mondaladi/AutoCutOffSystemforSolderingIron/Connections.png

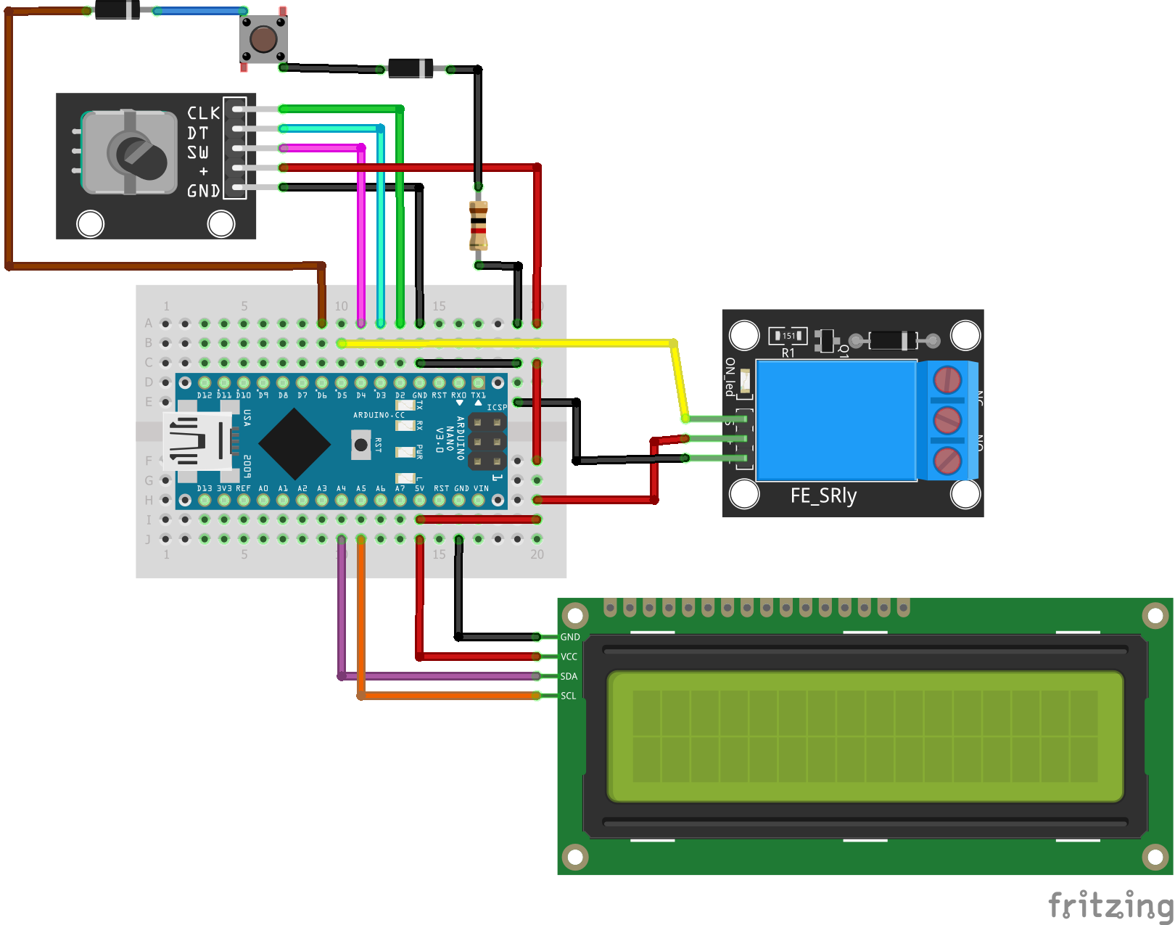
Connections.png
