mondaladi/AutoCutOffSystemforSolderingIron/(commit log)

2025-02-12 Arduino Code
2025-02-13 PCB Gerber Files
2025-04-16 release-V2.0
    Code for new version of SolderSysnc
2025-04-16 Update SmartSolderingStation_OLED.ino
    new release-V2.0: Code for new version of SolderSync
2025-04-16 Create soldersync-v2.ino
    new release-V2.0
